jaojao7/pi2_jpad/README.md

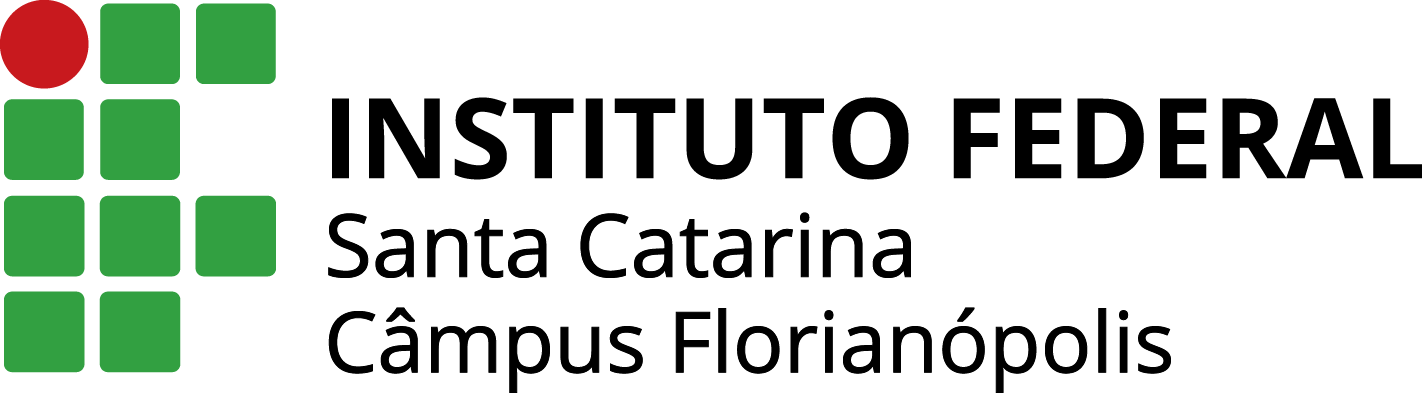
[picture p1: Imagens/ifsc.png]


# Seja bem vindo! 
## Repositório Destinado ao Desenvolvimento das Atividades da Unidade Curricular Projeto Integrador II

##### Clique nos tópicos abaixo para abrir a página referente:

* [Introdução](https://github.com/jaojao7/pi2_jpad/blob/main/introducao.md)
* [Concepção](https://github.com/jaojao7/pi2_jpad/blob/main/concepcao.md)
*  [Design](https://github.com/jaojao7/pi2_jpad/blob/main/design.md)
*  [Implementação](https://github.com/jaojao7/pi2_jpad/blob/main/implementacao.md) 
*  [Operação](https://github.com/jaojao7/pi2_jpad/blob/main/operacao.md)
