jaojao7/pi2_jpad/design.md

## Design do Projeto
Para a continuidade do projeto da inserção de tecnologias com a finalidade de realizar o processo de automatização residencial, entraremos agora na etapa do design, 
onde a estrutura e configuração de materiais necessários e como os mesmos poderão futuramente ser implementados começa a surgir.
Abaixo segue uma tabela com os componentes utilizados e suas respectivas descrições,  na sequência o esquemático da montagem:

Imagem |Componente   | Quantidade | Descrição/Utilização
:-------:|:---------: | :--------------:| :------ 
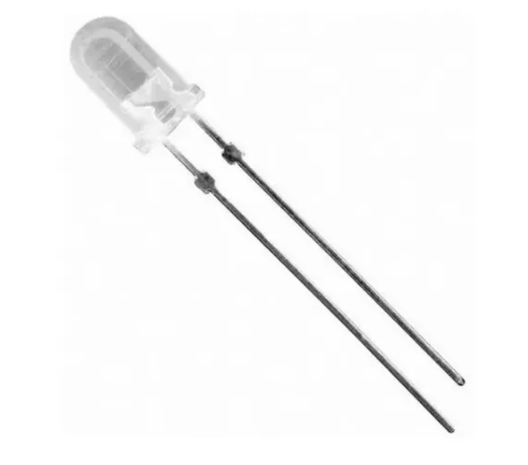
[picture p2: Imagens/led.png]
 |Led Branco 5mm | 10| Iluminação do projeto
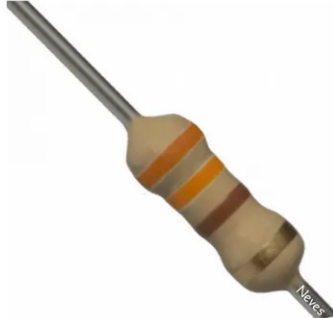
[picture p3: Imagens/330.png]
|Resistor 330Ω | 11| Utilizado na parte do alarme e na iluminação do projeto
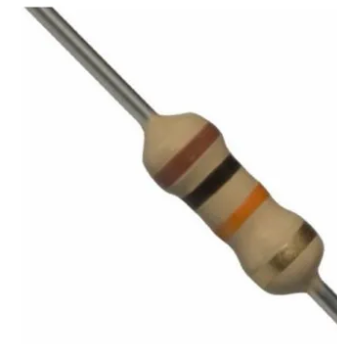
[picture p4: Imagens/10k.png]
|Resistor 10kΩ | 1 | Utilizado com o sensor DHT11
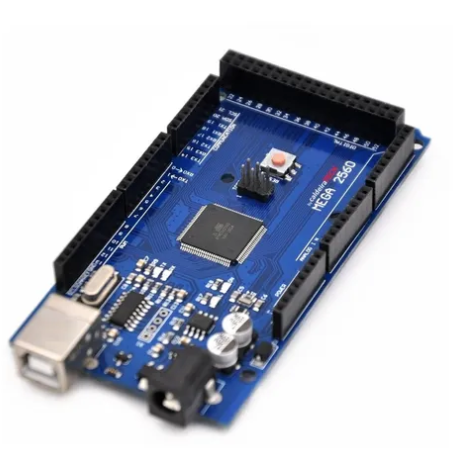
[picture p5: Imagens/mega.png]
|Placa Arduino Mega 2560 R3 |1|Utilizada para o desenvolvimento e funcionamento do projeto
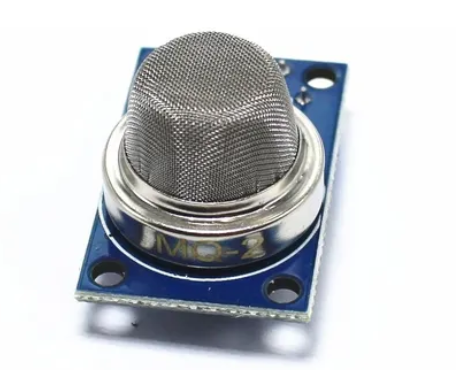
[picture p6: Imagens/mq2.png]
 |MQ-2|1|Sensor de Gás inflamável e de fumaça
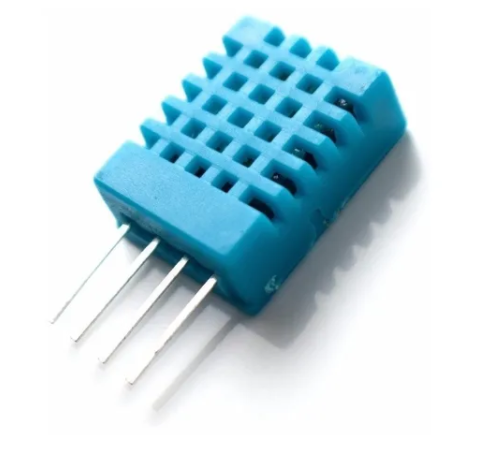
[picture p7: Imagens/dht11.png]
|DHT11|1|Sensor de umidade e temperatura 
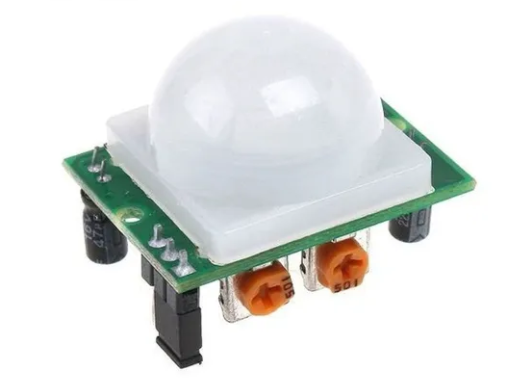
[picture p8: Imagens/pir.png]
|PIR|1|Sensor de presença
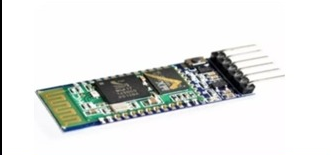
[picture p9: Imagens/bluetooth.png]
|Módulo HC-05|1|Módulo Bluetooth
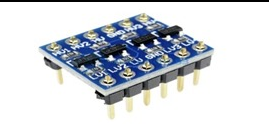
[picture p10: Imagens/conversor.png]
|Conversor de Nível Lógico RC|1|Conversor de Nível Lógico RC Bidirecional
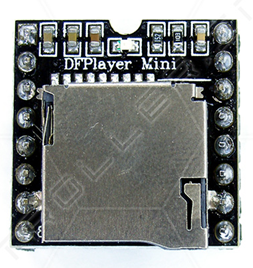
[picture p11: Imagens/df.png]
|Modulo DFPlayer|1|Utilizado na parte do alarme
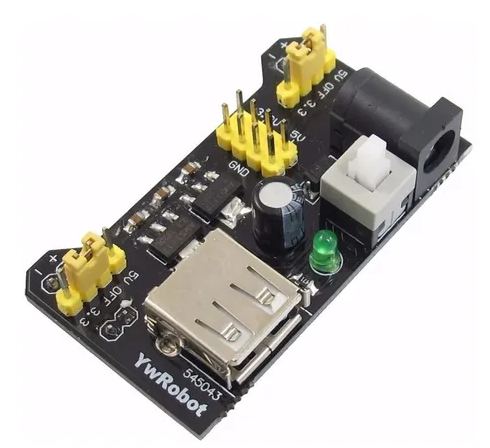
[picture p12: Imagens/mb102.png]
|Módulo MB102|1| Fonte de tensão ajustável
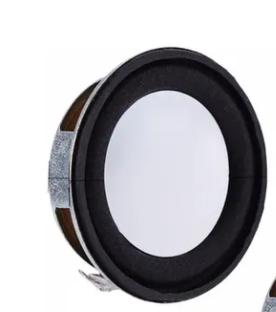
[picture p13: Imagens/auto.png]
|Auto falante 0.5W 8Ω|1|Utilizado na parte do alarme
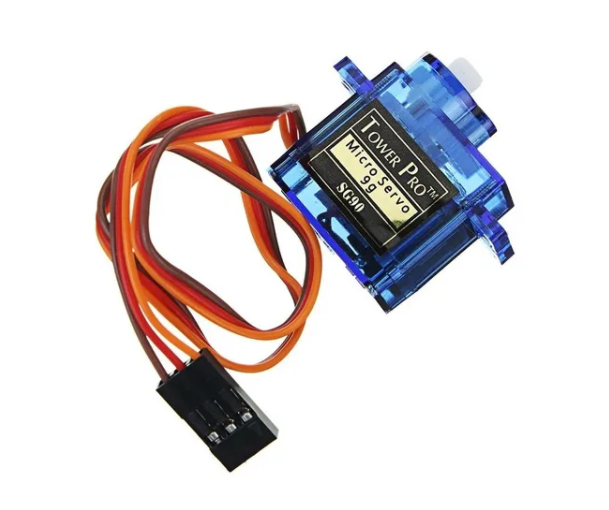
[picture p14: Imagens/servo.png]
|Servomotor|1|Utilizado no mecanismo de entrada da garagem

###### Figura 1 - Esquemático do Projeto  

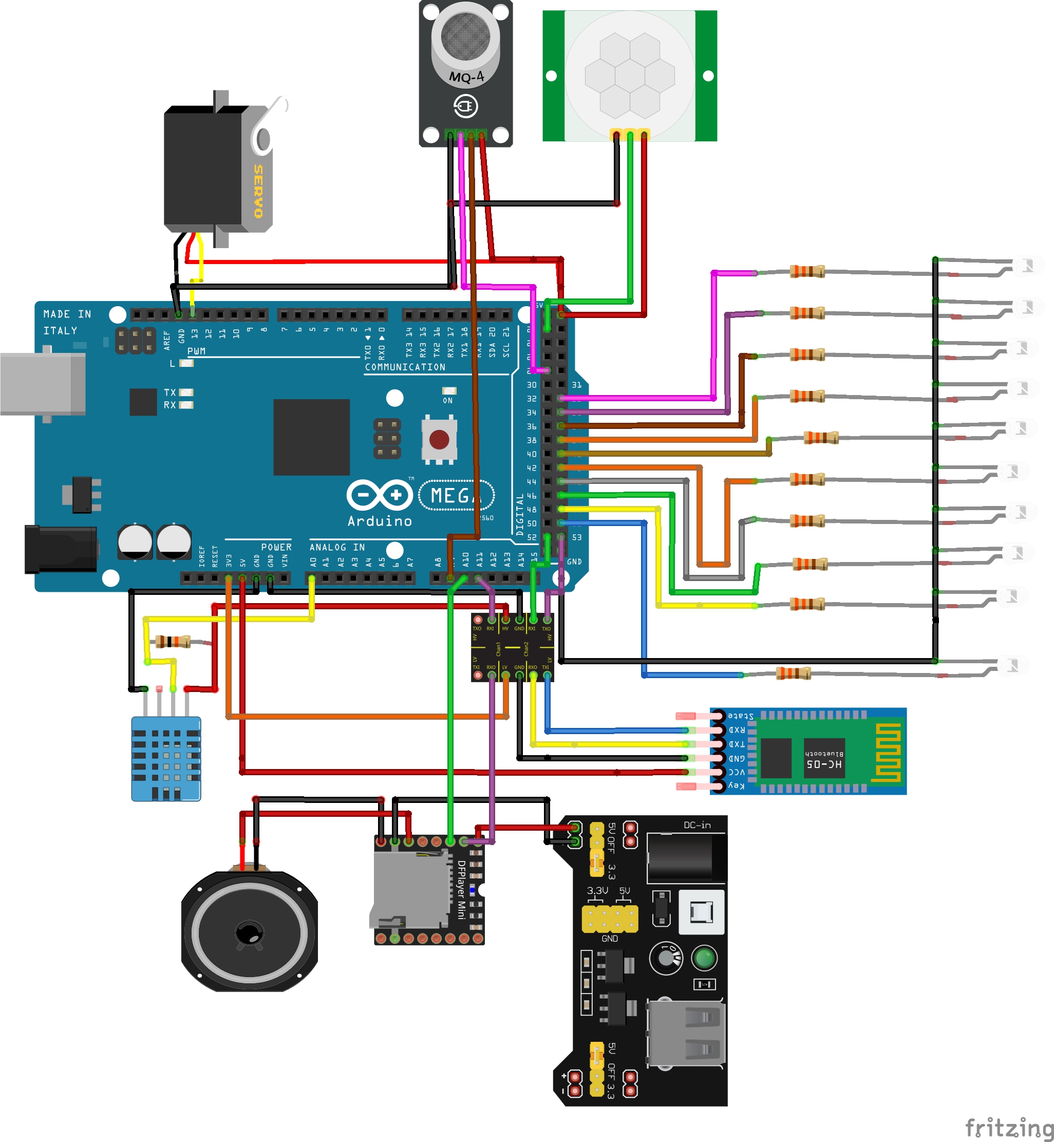
[picture p15: Imagens/projetofinal.jpg]


### Algumas Observações:

* Para utilização do módulo Bluetooth é necessário o conversor de nível lógico nas entradas RX e TX pois o mesmo trabalha com a tensão de 3.3V e as entradas do Arduino fornecem 5V.
* O amplificador PAM8403 é utilizado para melhoria do som, porém o sistema funcionaria sem o mesmo. Bastando conectar o autofalante diretamente nas entradas correspondentes no wtv020 SD.
* Atenção a tensão de alimentação do módulo wtv020 SD como sendo 3.3V.
* No sensor DHT11 é necessário um resistor de 10kΩ conectado as entradas VCC e de dados do componente.

### Aplicativo
Abaixo algumas imagens do aplicativo que será posteriormente utilizado para realizar o controle da casa:
###### Figura 2 - Tela de Login Incial  
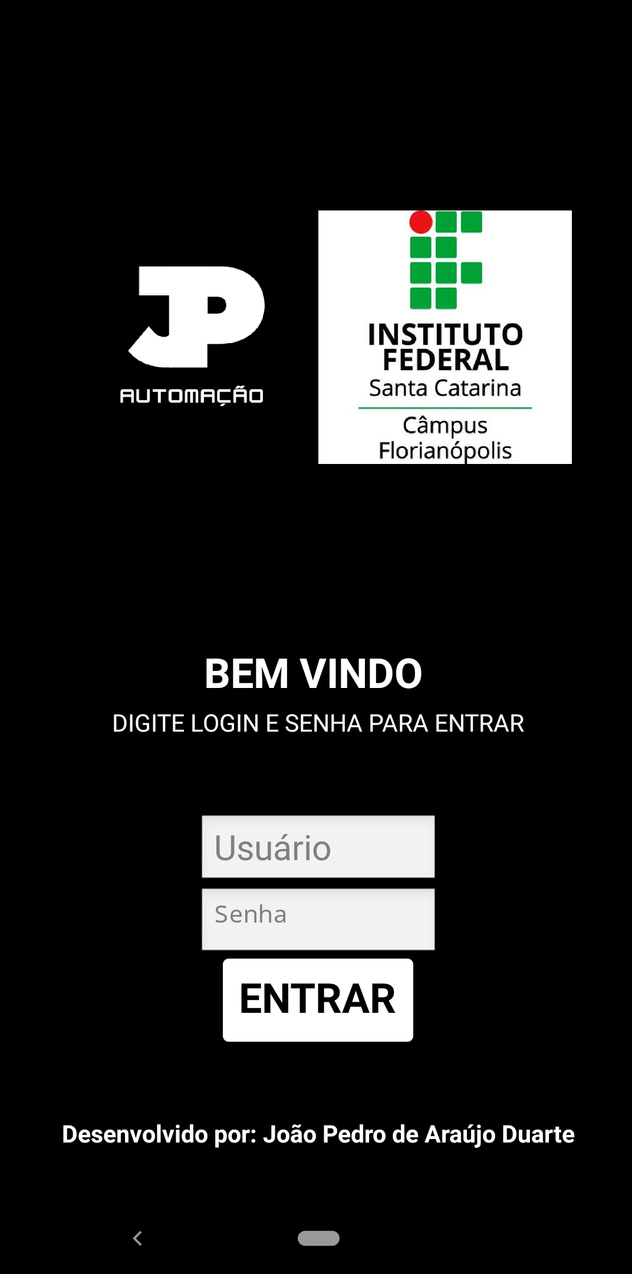
[picture p16: Imagens/iniciofinal.png]


###### Figura 3 - Tela Principal  
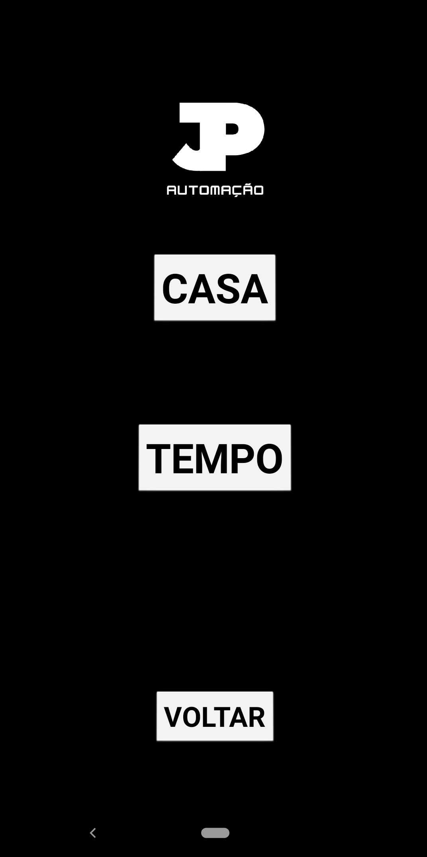
[picture p17: Imagens/telaprincipalfinal.png]


###### Figura 4 - Tela de controle casa 
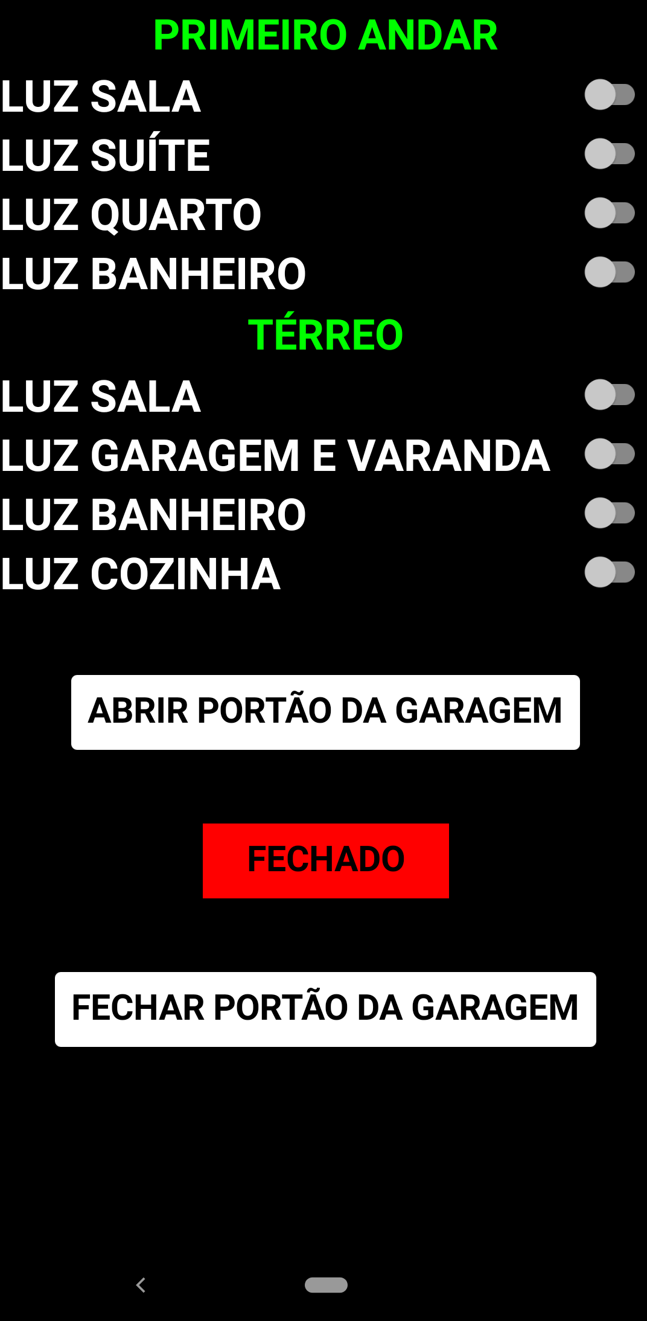
[picture p18: Imagens/telacontrolefinal.png]


###### Figura 5 - Tela Tempo 
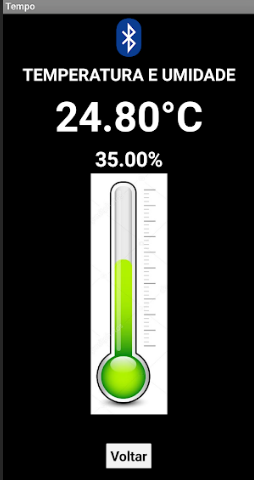
[picture p19: Imagens/telatemperatura.png]


Formam realizados alguns testes inicias referentes aos sensores e as lógicas de funcionamento antes de iniciar a implementação do sistema final
*  #### [Para acessar a página referente aos testes clique aqui](https://github.com/jaojao7/pi2_jpad/blob/main/testes.md)

[Para voltar a página inicial clique aqui.](https://github.com/jaojao7/pi2_jpad)
