jaojao7/pi2_jpad/operacao.md

# Operação

Nesta seção está disponível um vídeo para apresentação dos resultados da maquete.

Clique no link abaixo para assistir o vídeo:
<br> https://youtu.be/yk1Ng5Q3J3E

Como podemos verificar, o objetivo principal do trabalho foi alcançado. A aplicação de diversas tecnologias com o intuito de automatizar a residência maquete foi concluido, o sistema de alarme funcionando, e valores de temperatura e umidade devidamente apresentados.

### Erros e Problemáticas

Como todo protótipo, o produto uma vez que é atendido o seu objetivo geral, está passível de erros e questões problemáticas secundárias. Erros estes de segunda ordem, ou seja, que não afetam o funcionamento principal do produto. Neste texto ressalto duas questões problemáticas principais relacionadas ao funcionamento do projeto acima demonstrado. A primeira é a interferência no servo motor vísivel pelas trepidações a cada momento de leitura do módulo Bluetooth. E a segunda, está relacionada ao acionamento involuntário e aleatório de algumas luzes de determinados comôdos, ocasionados no momento de troca da tela no aplicativo. Erro este gerado, pois, na troca da tela o dispositivo é desconectado temporariamente e reconectado em seguida, essa reconexão gera então esse erro. Estas questões são pontos de incentivo para melhor estudo e pesquisa futuros, utilizando os equipamentos necessários para verificá-los e posteriormente atualizar e implementar tais melhorias a maquete.
