jaojao7/pi2_jpad/introducao.md

  
  # Domótica
  A domótica é o processo de integração dos recursos tecnológicos para gerir questões habitacionais. Surge para facilitar o uso e otimizar os recursos que os indivíduos imersos no meio habitacional utilizam, uma vez que ações antes descentralizadas, passam a pertencer a um único sistema gestor final geral que ramifica as funções antes independentes.
  <p>Podemos verificar alguns exemplos como, o acionamento de lâmpadas nos cômodos de uma residência, ligar sistemas de ar-condicionado e sua alteração de temperatura, iniciar a irrigação do jardim, ligar o sistema de alarme, janelas, enfim, uma infinidade de funções que antes dependiam da atenção direta do proprietário, agora com a utilização dos recursos no estudo da domótica, possibilita concentrar essas atividades e controla-lás mais facilemnte e até automaticamente.<p>
  <p>Um dos vários reflexos positivos e úteis fora a praticidade e boa usuabilidade da utilização desse sistema de controle e automação é de que, oportuniza o total controle a indivíduos com alguma deficiência ou mobilidade reduzida, idosos que não podem realizar, ou realizam com alguma dificiculdade o controle das funções da casa. A busca por maneiras de facilitar o dia a dia e as tarefas rotineiras tornam esse tipo de tecnologia facilmente receptiva por parte da sociedade em geral. Abrindo caminhos para novos empregos, formações e para o maior desenvolvimento de sistemas de hardware e software tornando-os mais eficientes e fluídos para utilização do usuário final.<p>
    <p>A comodidade do total controle desde equipamentos independentes e,ou em sistemas interconectados ao alcance da mão parece bem convidativo. Mas é necessário um estudo do seu correto uso para garantia da segurança, uma vez que, equipamentos interligados em um servidor comum, ou agregado de servidores estão propícios a ciberataques, podendo afetar desde residências a cidades inteiras dependendo do quantitativo que esta tecnologia foi empregada. <p>

 ###### Figura 1 - Domótica   
         
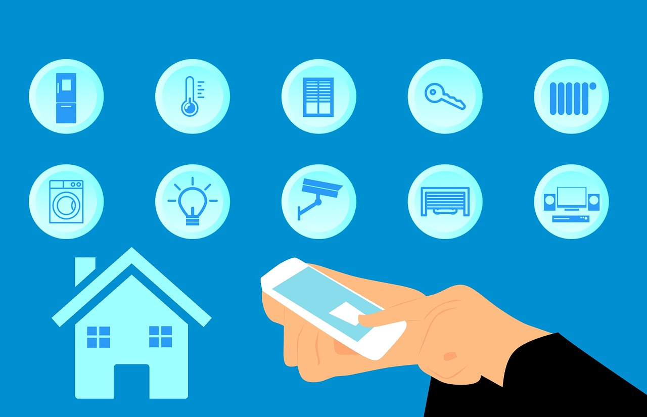
[picture p42: Imagens/home-4100193_1280.jpg]
DOMÓTICA
  

## Referências
    
* SISLITE (Portugal) (org.). **O QUE É A DOMÓTICA?** Disponível em: http://www.sislite.pt/domus.htm. Acesso em: 03 jun. 2021.
 * TEZA, Vanderlei Rabelo. **ALGUNS ASPECTOS SOBRE A AUTOMAÇÃO RESIDENCIAL - DOMÓTICA**. 2002. 108 f. Dissertação (Mestrado) - Curso de Ciência da Computação, Universidade Federal de Santa Catarina, Florianópolis, 2002.

[Para voltar a página inicial clique aqui.](https://github.com/jaojao7/pi2_jpad)
