jaojao7/pi2_jpad/Imagens/680.png

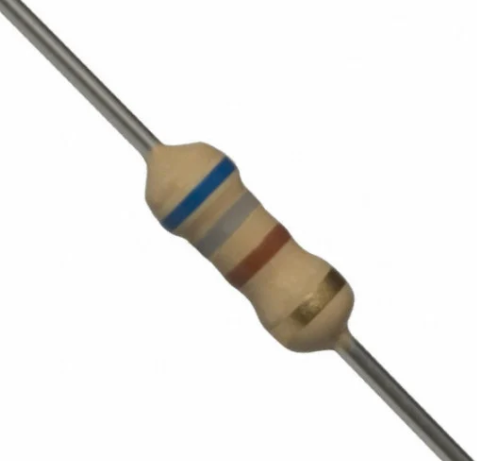
Imagens/680.png
