jaojao7/pi2_jpad/Imagens/fios.jpg

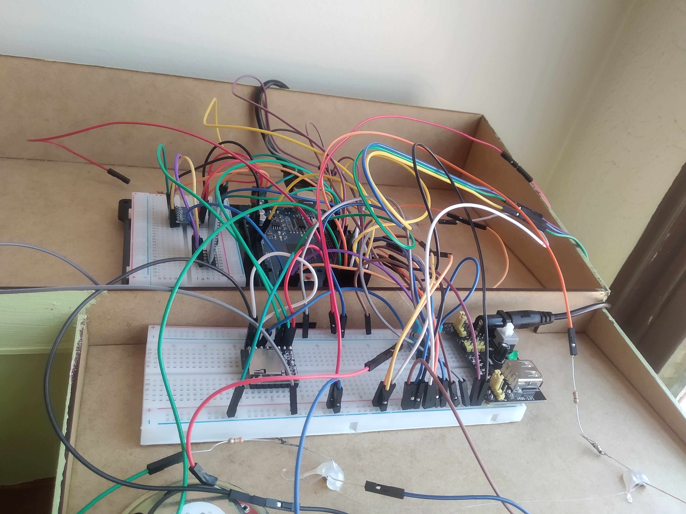
Imagens/fios.jpg
