jaojao7/pi2_jpad/Imagens/player.png

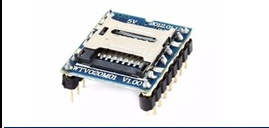
Imagens/player.png
