jaojao7/pi2_jpad/terreotela.png

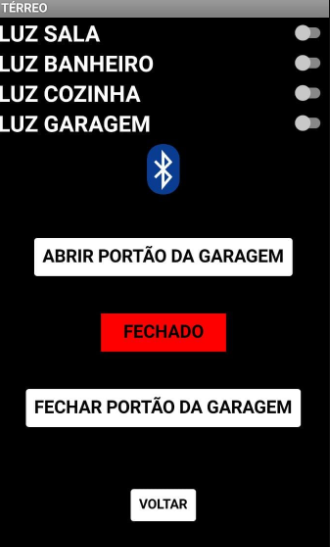
terreotela.png
