jaojao7/pi2_jpad/testes.md

# Testes

Para a etapa de testes, o conjunto de funcionalidades foi dividido nos seguintes blocos, clique no tópico abaixo referente ao que deseja abrir:
* [Garagem](https://github.com/jaojao7/pi2_jpad/blob/main/garagem.md)
* [Tempo](https://github.com/jaojao7/pi2_jpad/blob/main/tempo.md)
* [Alarme](https://github.com/jaojao7/pi2_jpad/blob/main/alarme.md)
* [Iluminação](https://github.com/jaojao7/pi2_jpad/blob/main/iluminacao.md)

Esta página trata dos testes realizados individualmente para cada bloco.

[PARA VOLTAR AO INÍCIO CLIQUE AQUI](https://github.com/jaojao7/pi2_jpad)
